Digital-Waters/WaterMonitorDeviceESP32/README.md

# DigitalWaters_WD_prototype
Simplified Schematic for prototype release
