Digital-Waters/WaterMonitorDeviceESP32/(threads)

Thread 2 (2025-07-31):

Mixed 5V, 3.3V rails

atop8918, 2025-07-31:
I mixed the 3.3V and 5V rails with some peripherals -- namely the DH20 internal temp / humidity sensor and the Atlas Scientific isolation board. These are powered by the 5V and switched 5V rails, respectively but both are connected to the 3.3V I2C bus.
Solution:
- Add a 3.3V switched rail and connect both DH20 and Electrial Isolation peripherals to this rail rather than their current 5V rails.

Thread 5 (2025-08-09):

Identify and implement a more reliable sensor connection scheme

atop8918, 2025-08-09:
We are dealing with a number of different probe types. Some come with BNC connectors, some with mini BNC (SMA?) and still others are bare wire or other types.
For our potentially highly-humid environment, standard tin/nickel plated connectors will quickly corrode resulting in unreliable data. A step up would have us using gold-plated connectors but that is both more expensive and has some other corrosion pathways (mixed metal connections, e.g. nickel plating on sensor pins and gold plating on socket may result in galvanic corrosion.

Ideally sensors would be soldered directly to the PCB and then potted or use waterproof IP68+ connections. This is a big TBD.

Thread 6 (2025-08-09):

Sustainability

atop8918, 2025-08-09:
One core goal of DW is to do water monitoring without introducing a lot of additional waste. Instead of using traditional PCBs it would be nice if we could instead use some kind of compostable substrate such as paper or PLA. This may require the use of additive circuit manufacturing rather than traditional chemical etching but it will provide a very big step in sustainability. It will also require some field testing to ensure that some decent minimum device lifetime is achieved.

Thread 7 (2025-08-10):

As a device I need a more quantitative water colour sensor.

atop8918, 2025-08-10:
Using a camera coupled with "white" LEDs as a colour detector has some drawbacks:
Camera CCDs are usually tuned to RGB pixels -- likewise "white" LEDs are typically composed of RGB elements. While to our eyes this looks fine, in the real world there are distinct wavelengths that can get lost when either illuminated or detected with a 3-base colour scheme. Sodium, for example, has a very distinct 'D' spectral line at ~588nm. This corresponds to a gap in between many CCD detectors between the peak red and green pixels at ~600nm and ~520nm, respectively. Those wavelengths also correspond to LED illumination of the same colours.
To this end, using a multi-spectral colour detector such as the AS73343 with 14 colour channels, including 11 visible-light detectors, IR, and clear detectors. Using multi-spectral LEDs or additional coloured / phospohered LEDs in order to "fill in tht gaps" that many ordinary white LEDs leave would also provide better colour data overall.

Why is this important? Spectral information  provides a lot of quantitative data about the content of the water, and can be coupled with other sensoor data to help design a data model. Illumination and spectral sensors are very cheap compared with other water quality sensors, and can potentially provide more data on biological and turbidity conditions.

Thread 10 (2025-08-11):

Swap TLV4387 with 2387 for cost savings

atop8918, 2025-08-11:
The TLV4387 buffered reference outputs seem like they are stiff enough to be shared rather than have separate buffers for different circuits. This would save some money as the TLV is a relatively expensive part.

Thread 11 (2025-08-11):

Audit powerup requirements for switched power components

atop8918, 2025-08-11:
Some of the switched components on the board do not seem to like the power going out on them. Namely the DHT20 doesn't reliably recover after a switch-on event.
This is with rellatively fast on-off switching ( 5-10 seconds off ) so it is possible that with a more reasonably on-off schedule the unit will be more coperative. It is also reasonable to assume that the unit needs more stringent power up rail requirements and so we may need to provide a more consistent power on sequence.

Thread 8 (2025-08-11):

Silkscreen additions

atop8918, 2025-08-11:
Some of the connectors are pretty ambiguous -- especially considering that they are non-polarized 2 or 3-pin headers. For the next rev, if headers are still used, we'll need some more info like pin 1, or Vcc/GND, etc. indicators to avoid plugging some of the polarized sensors in backwards (e.g. the turbidity sensor)

Thread 9 (2025-08-11):

Vref to ADC is not stiff enough

atop8918, 2025-08-11:
The 4.096 reference voltage to the ADC is not stiff enough to handle the power peaks when sampling. This pin is supplied directly from the 4.096 voltage regulator (REF3040) but jumps quite a bit when the ADC is sampling. The ripple is coupling to the buffered 4096V reference lines which effects those circuits as well.
I think a better approach might be to supply the ADC with either one of the existing buffered 4.096 lines or to add another op amp buffer.
Note: This is confirmed: removed ADC Vref from the 3040 and attached to pin 1 of the TLV4387 and no ripple is evident when sampling.

Additional: I will add this as a feature request, but we may be able to use a smaller buffer op amp (TLV2387) to save some money and board space as the buffers seem stiff enough to be shared.

Thread 13 (2025-08-19):

As a system I would like a "dirty" flag to mark uncorrected data records

atop8918, 2025-08-19:
Calibration corrections will be supplied with each device for each sensor via the external EEPROM. There is the possibility that this record will become corrupt or deleted or have failed to have been written in the first place. Data coming from these devices should be marked "dirty" so they can be corrected later.
We should have a copy of each device's calibration table in the database associated with the device entry. The cal values can be used to correct the data in the cloud when being used or by some periodically running batch script.

Thread 14 (2025-08-19):

As a device I need to expose the ADC reference voltage for calibration

atop8918, 2025-08-19:
We need at a test point near the ADC VREF pin (MC3208 pin 15) and the analog ground pin (pin 14). For production these should be routed from each board through the platter/carrier to a debug header for bulk calibration.
