Digital-Waters/WaterMonitorDeviceESP32/board.pdf

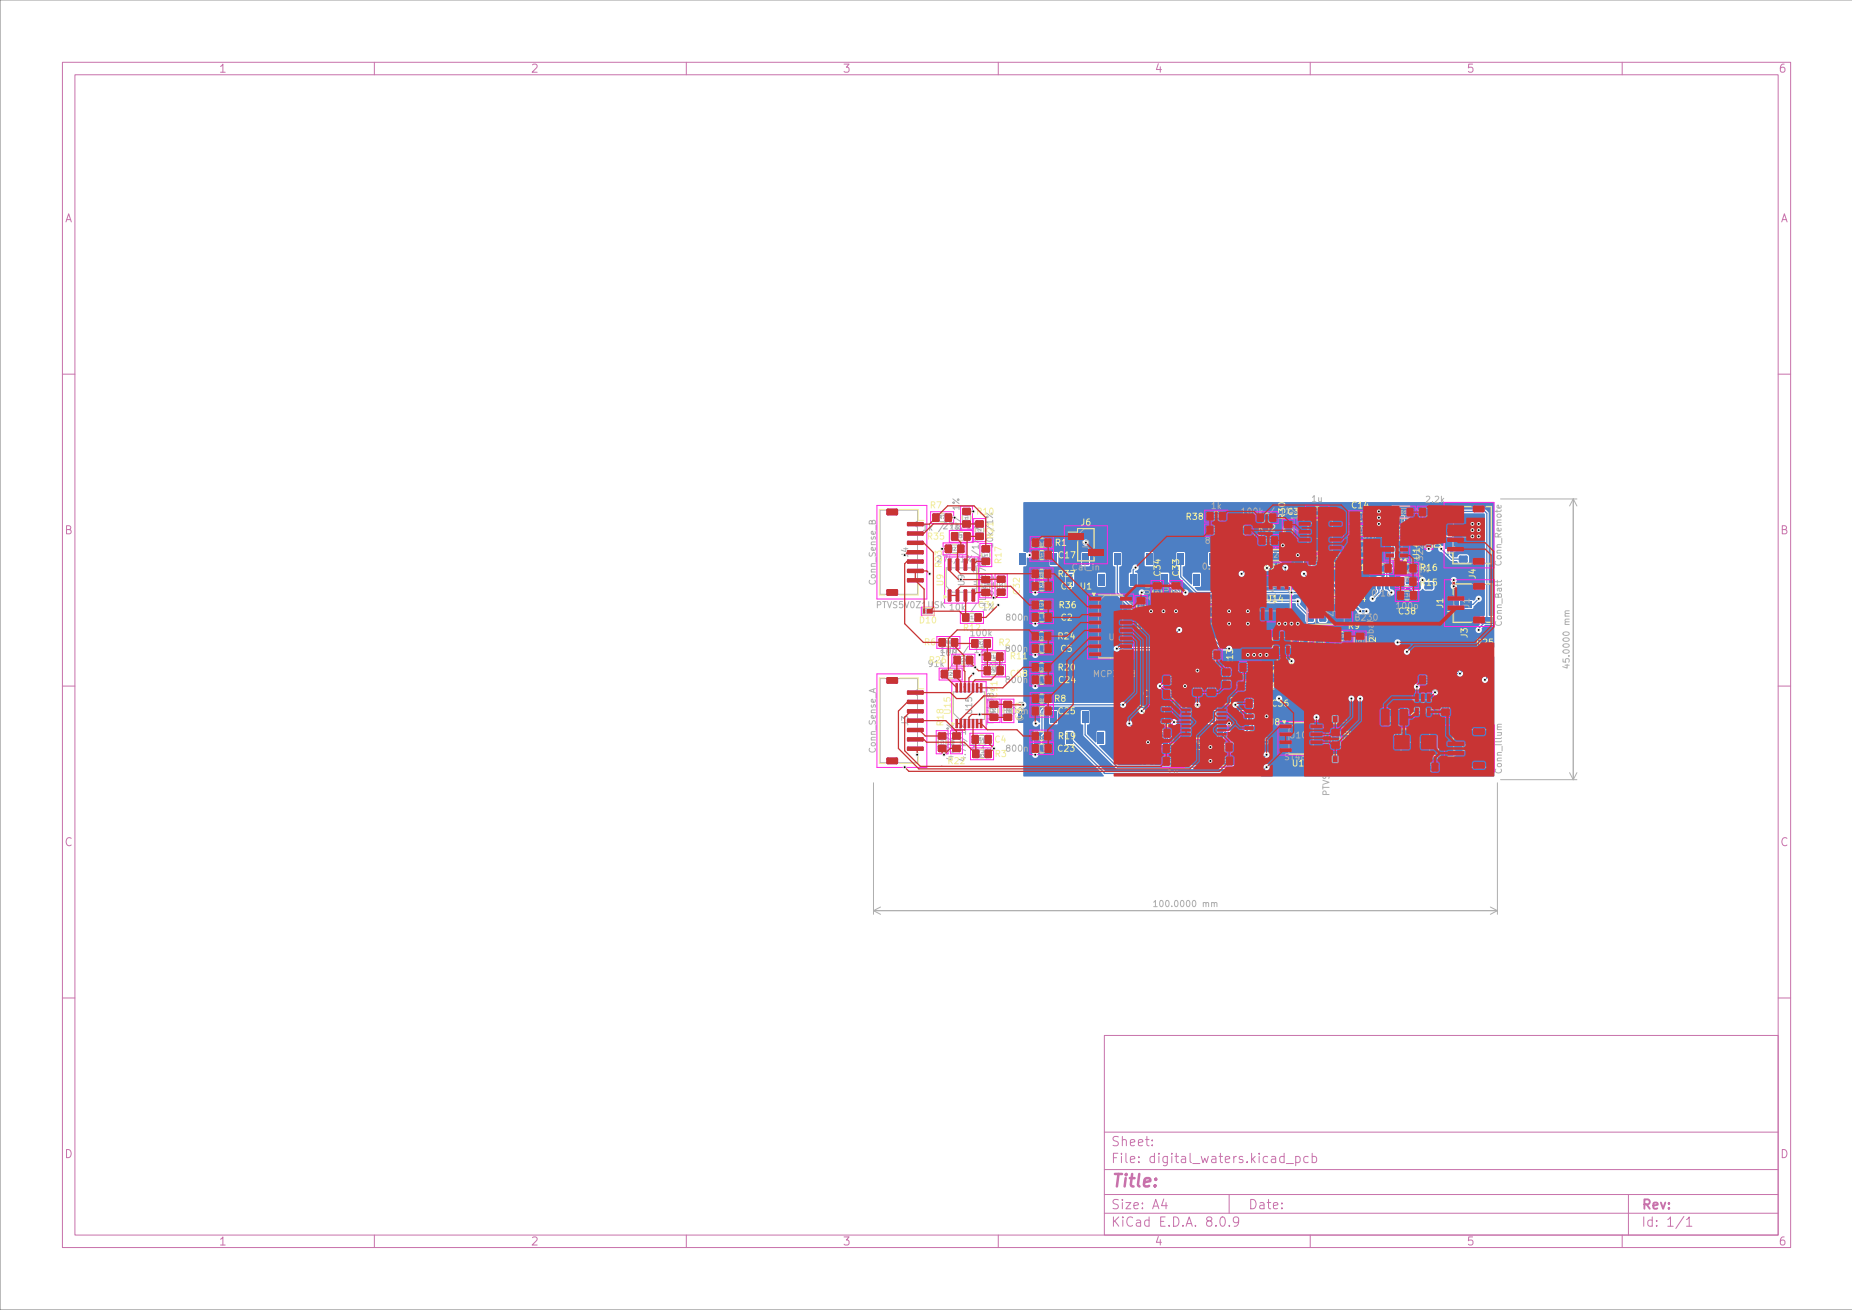
[picture p1: page 1]
