Digital-Waters/WaterMonitorDeviceESP32/digital_waters.kicad_pcb

## KiCad design digital_waters.kicad_pcb (2025-11-18)

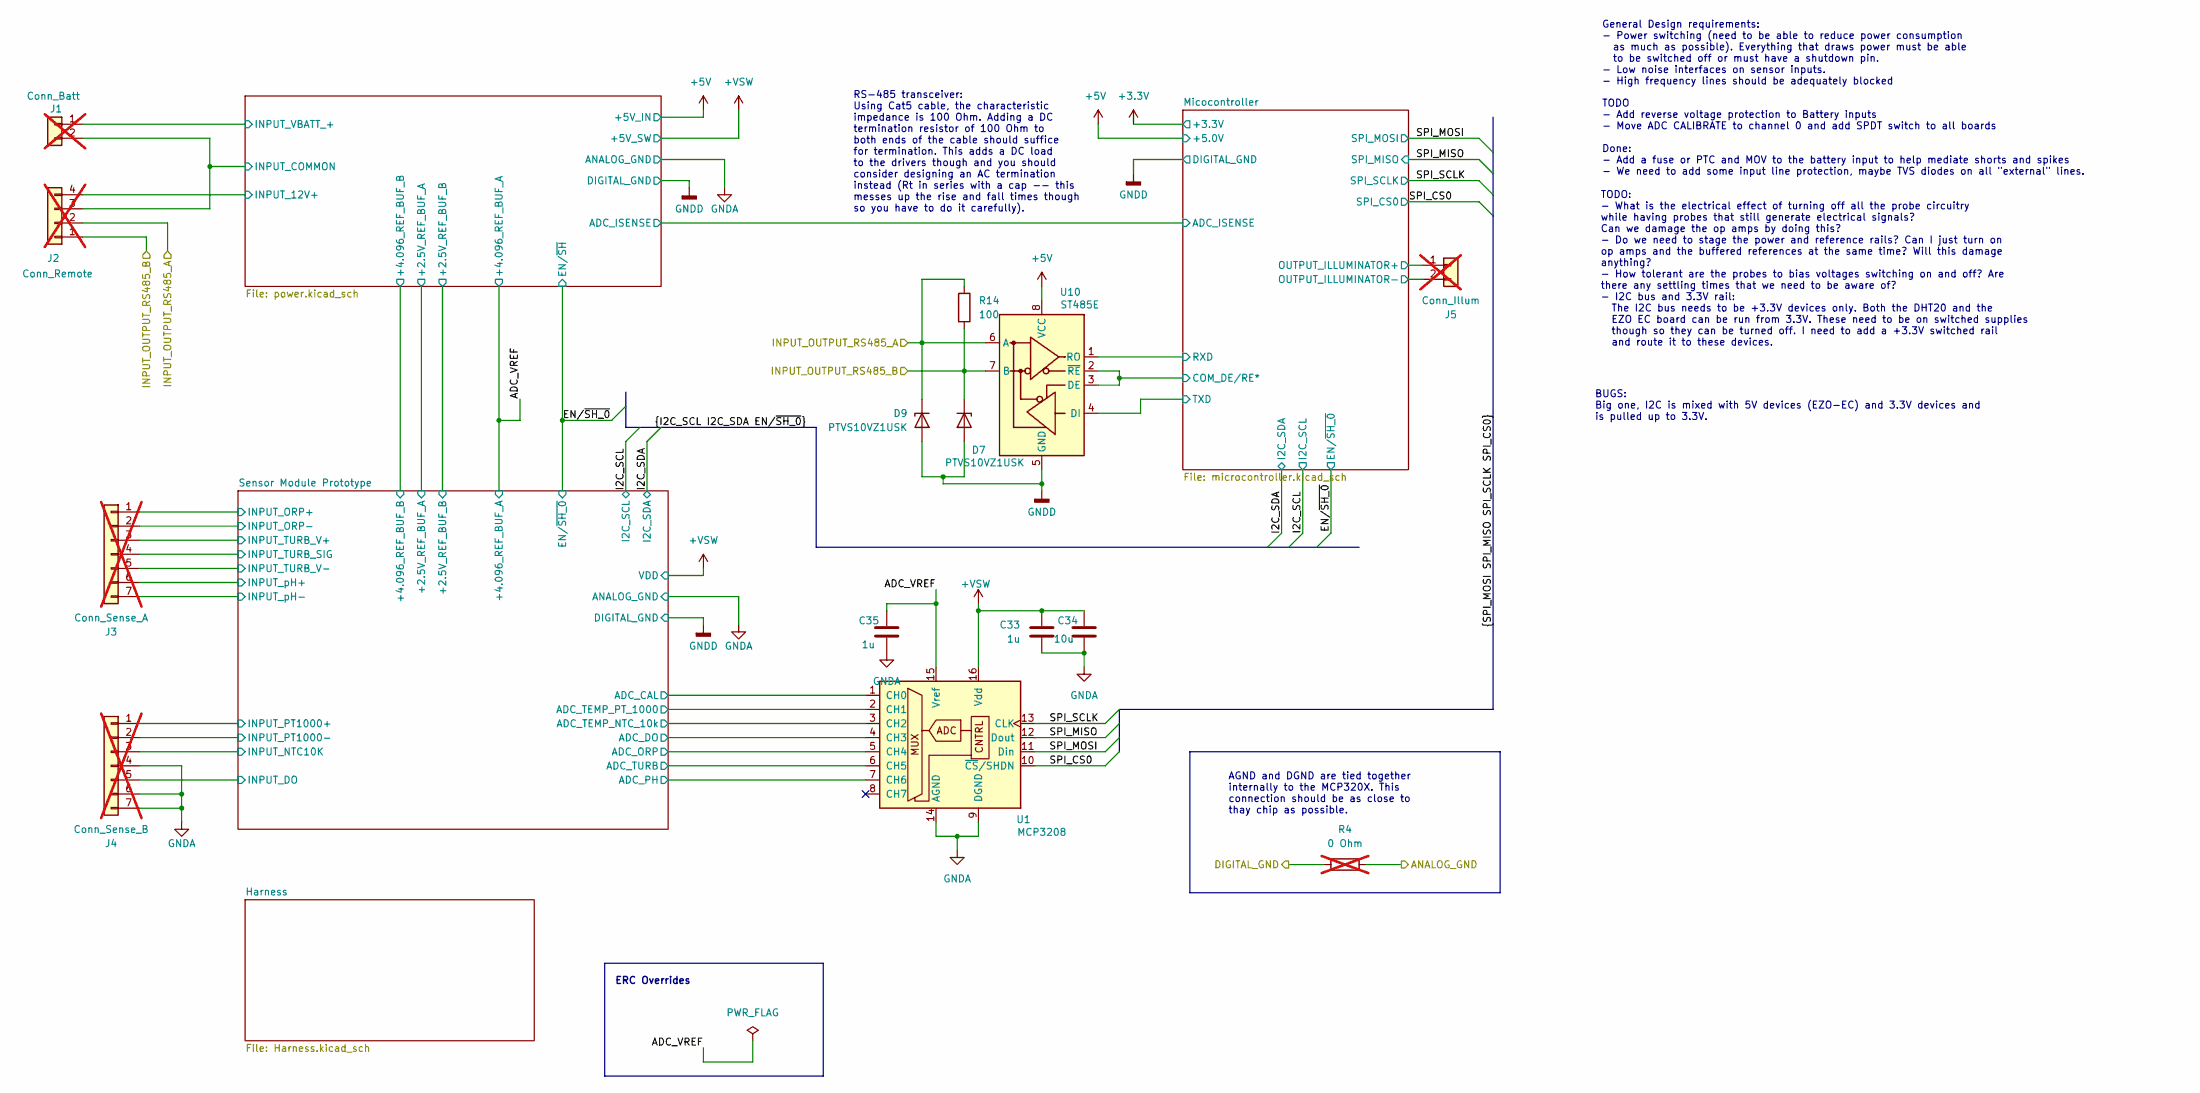
[picture p6: schematic digital_waters.kicad_sch]

Parts:
C33, C35: 1u; C_0805_2012Metric_Pad1.18x1.45mm_HandSolder; MPN CL21B105KOFNNNG
C34: 10u; C_0805_2012Metric_Pad1.18x1.45mm_HandSolder; MPN CL21B106KPQNNNE
D7, D9: PTVS10VZ1USK; Nexperia_DSN1608-2_1.6x0.8mm; MPN PTVS10VZ1USK
J1: Conn_Batt; JST_ZH_S2B-ZR-SM4A-TF_1x02-1MP_P1.50mm_Horizontal; not fitted
J2: Conn_Remote; JST_ZH_S4B-ZR-SM4A-TF_1x04-1MP_P1.50mm_Horizontal; not fitted
J3: Conn_Sense_A; JST_ZH_S7B-ZR-SM4A-TF_1x07-1MP_P1.50mm_Horizontal; not fitted
J4: Conn_Sense_B; JST_ZH_S7B-ZR-SM4A-TF_1x07-1MP_P1.50mm_Horizontal; not fitted
J5: Conn_Illum; JST_ZH_S2B-ZR-SM4A-TF_1x02-1MP_P1.50mm_Horizontal; not fitted
R4: 0 Ohm; R_1206_3216Metric_Pad1.30x1.75mm_HandSolder; not fitted
R14: 100; R_0805_2012Metric_Pad1.20x1.40mm_HandSolder; MPN AC0805FR-7W100RL
U1: MCP3208; SOIC-16_3.9x9.9mm_P1.27mm; MPN MCP3208-CI/SL
U10: ST485E; SOIC-8_3.9x4.9mm_P1.27mm; MPN ST485EBDR

Connections:
+5V: U10.8 (VCC); also elsewhere on the board
+VSW: C33.1, C34.1, U1.16 (Vdd); also elsewhere on the board
/ADC_VREF: C35.1, U1.15 (Vref); also elsewhere on the board
/INPUT_OUTPUT_RS485_A: D9.1 (K), J2.2, R14.1, U10.6 (A)
/INPUT_OUTPUT_RS485_B: D7.1 (K), J2.1, R14.2, U10.7 (B)
/Micocontroller/COM_DE/RE*: U10.2 (~RE), U10.3 (DE); also elsewhere on the board
/Micocontroller/OUTPUT_ILLUMINATOR+: J5.1; also elsewhere on the board
/Micocontroller/OUTPUT_ILLUMINATOR-: J5.2; also elsewhere on the board
/Micocontroller/RXD: U10.1 (RO); also elsewhere on the board
/Micocontroller/TXD: U10.4 (DI); also elsewhere on the board
/Power/+2.5V_REF_BUF_A: J3.7; also elsewhere on the board
/Power/+2.5V_REF_BUF_B: J3.2; also elsewhere on the board
/Power/+4.096_REF_BUF_B: J3.3; also elsewhere on the board
/Power/INPUT_12V+: J2.4; also elsewhere on the board
/Power/INPUT_COMMON: J1.2, J2.3; also elsewhere on the board
/Power/INPUT_VBATT_+: J1.1; also elsewhere on the board
/SPI_CS0: U1.10 (~CS/SHDN); also elsewhere on the board
/SPI_MISO: U1.12 (Dout); also elsewhere on the board
/SPI_MOSI: U1.11 (Din); also elsewhere on the board
/SPI_SCLK: U1.13 (CLK); also elsewhere on the board
/Sensor Module Prototype/ADC_CAL: U1.1 (CH0); also elsewhere on the board
/Sensor Module Prototype/ADC_DO: U1.4 (CH3); also elsewhere on the board
/Sensor Module Prototype/ADC_ORP: U1.5 (CH4); also elsewhere on the board
/Sensor Module Prototype/ADC_PH: U1.7 (CH6); also elsewhere on the board
/Sensor Module Prototype/ADC_TEMP_NTC_10k: U1.3 (CH2); also elsewhere on the board
/Sensor Module Prototype/ADC_TEMP_PT_1000: U1.2 (CH1); also elsewhere on the board
/Sensor Module Prototype/ADC_TURB: U1.6 (CH5); also elsewhere on the board
/Sensor Module Prototype/INPUT_DO: J4.5; also elsewhere on the board
/Sensor Module Prototype/INPUT_NTC10K: J4.3; also elsewhere on the board
/Sensor Module Prototype/INPUT_ORP+: J3.1; also elsewhere on the board
/Sensor Module Prototype/INPUT_PT1000+: J4.1; also elsewhere on the board
/Sensor Module Prototype/INPUT_PT1000-: J4.2; also elsewhere on the board
/Sensor Module Prototype/INPUT_TURB_SIG: J3.4; also elsewhere on the board
/Sensor Module Prototype/INPUT_TURB_V-: J3.5; also elsewhere on the board
/Sensor Module Prototype/INPUT_pH+: J3.6; also elsewhere on the board
GNDA: C33.2, C34.2, C35.2, J4.4, J4.6, J4.7, R4.2, U1.9 (DGND), U1.14 (AGND); also elsewhere on the board
GNDD: D7.2 (A), D9.2 (A), R4.1, U10.5 (GND); also elsewhere on the board

Notes on the sheet:
BUGS: Big one, I2C is mixed with 5V devices (EZO-EC) and 3.3V devices and is pulled up to 3.3V.
TODO: - What is the electrical effect of turning off all the probe circuitry while having probes that still generate electrical signals? Can we damage the op amps by doing this? - Do we need to stage the power and reference rails? Can I just turn on op amps and the buffered references at the same t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
RS-485 transceiver: Using Cat5 cable, the characteristic impedance is 100 Ohm. Adding a DC termination resistor of 100 Ohm to both ends of the cable should suffice for termination. This adds a DC load to the drivers though and you should consider designing an AC termination instead (Rt in series wi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
ERC Overrides
AGND and DGND are tied together internally to the MCP320X. This connection should be as close to thay chip as possible.
TODO - Add reverse voltage protection to Battery inputs - Move ADC CALIBRATE to channel 0 and add SPDT switch to all boards Done: - Add a fuse or PTC and MOV to the battery input to help mediate shorts and spikes - We need to add some input line protection, maybe TVS diodes on all "external" lines.
General Design requirements: - Power switching (need to be able to reduce power consumption as much as possible). Everything that draws power must be able to be switched off or must have a shutdown pin. - Low noise interfaces on sensor inputs. - High frequency lines should be adequately blocked

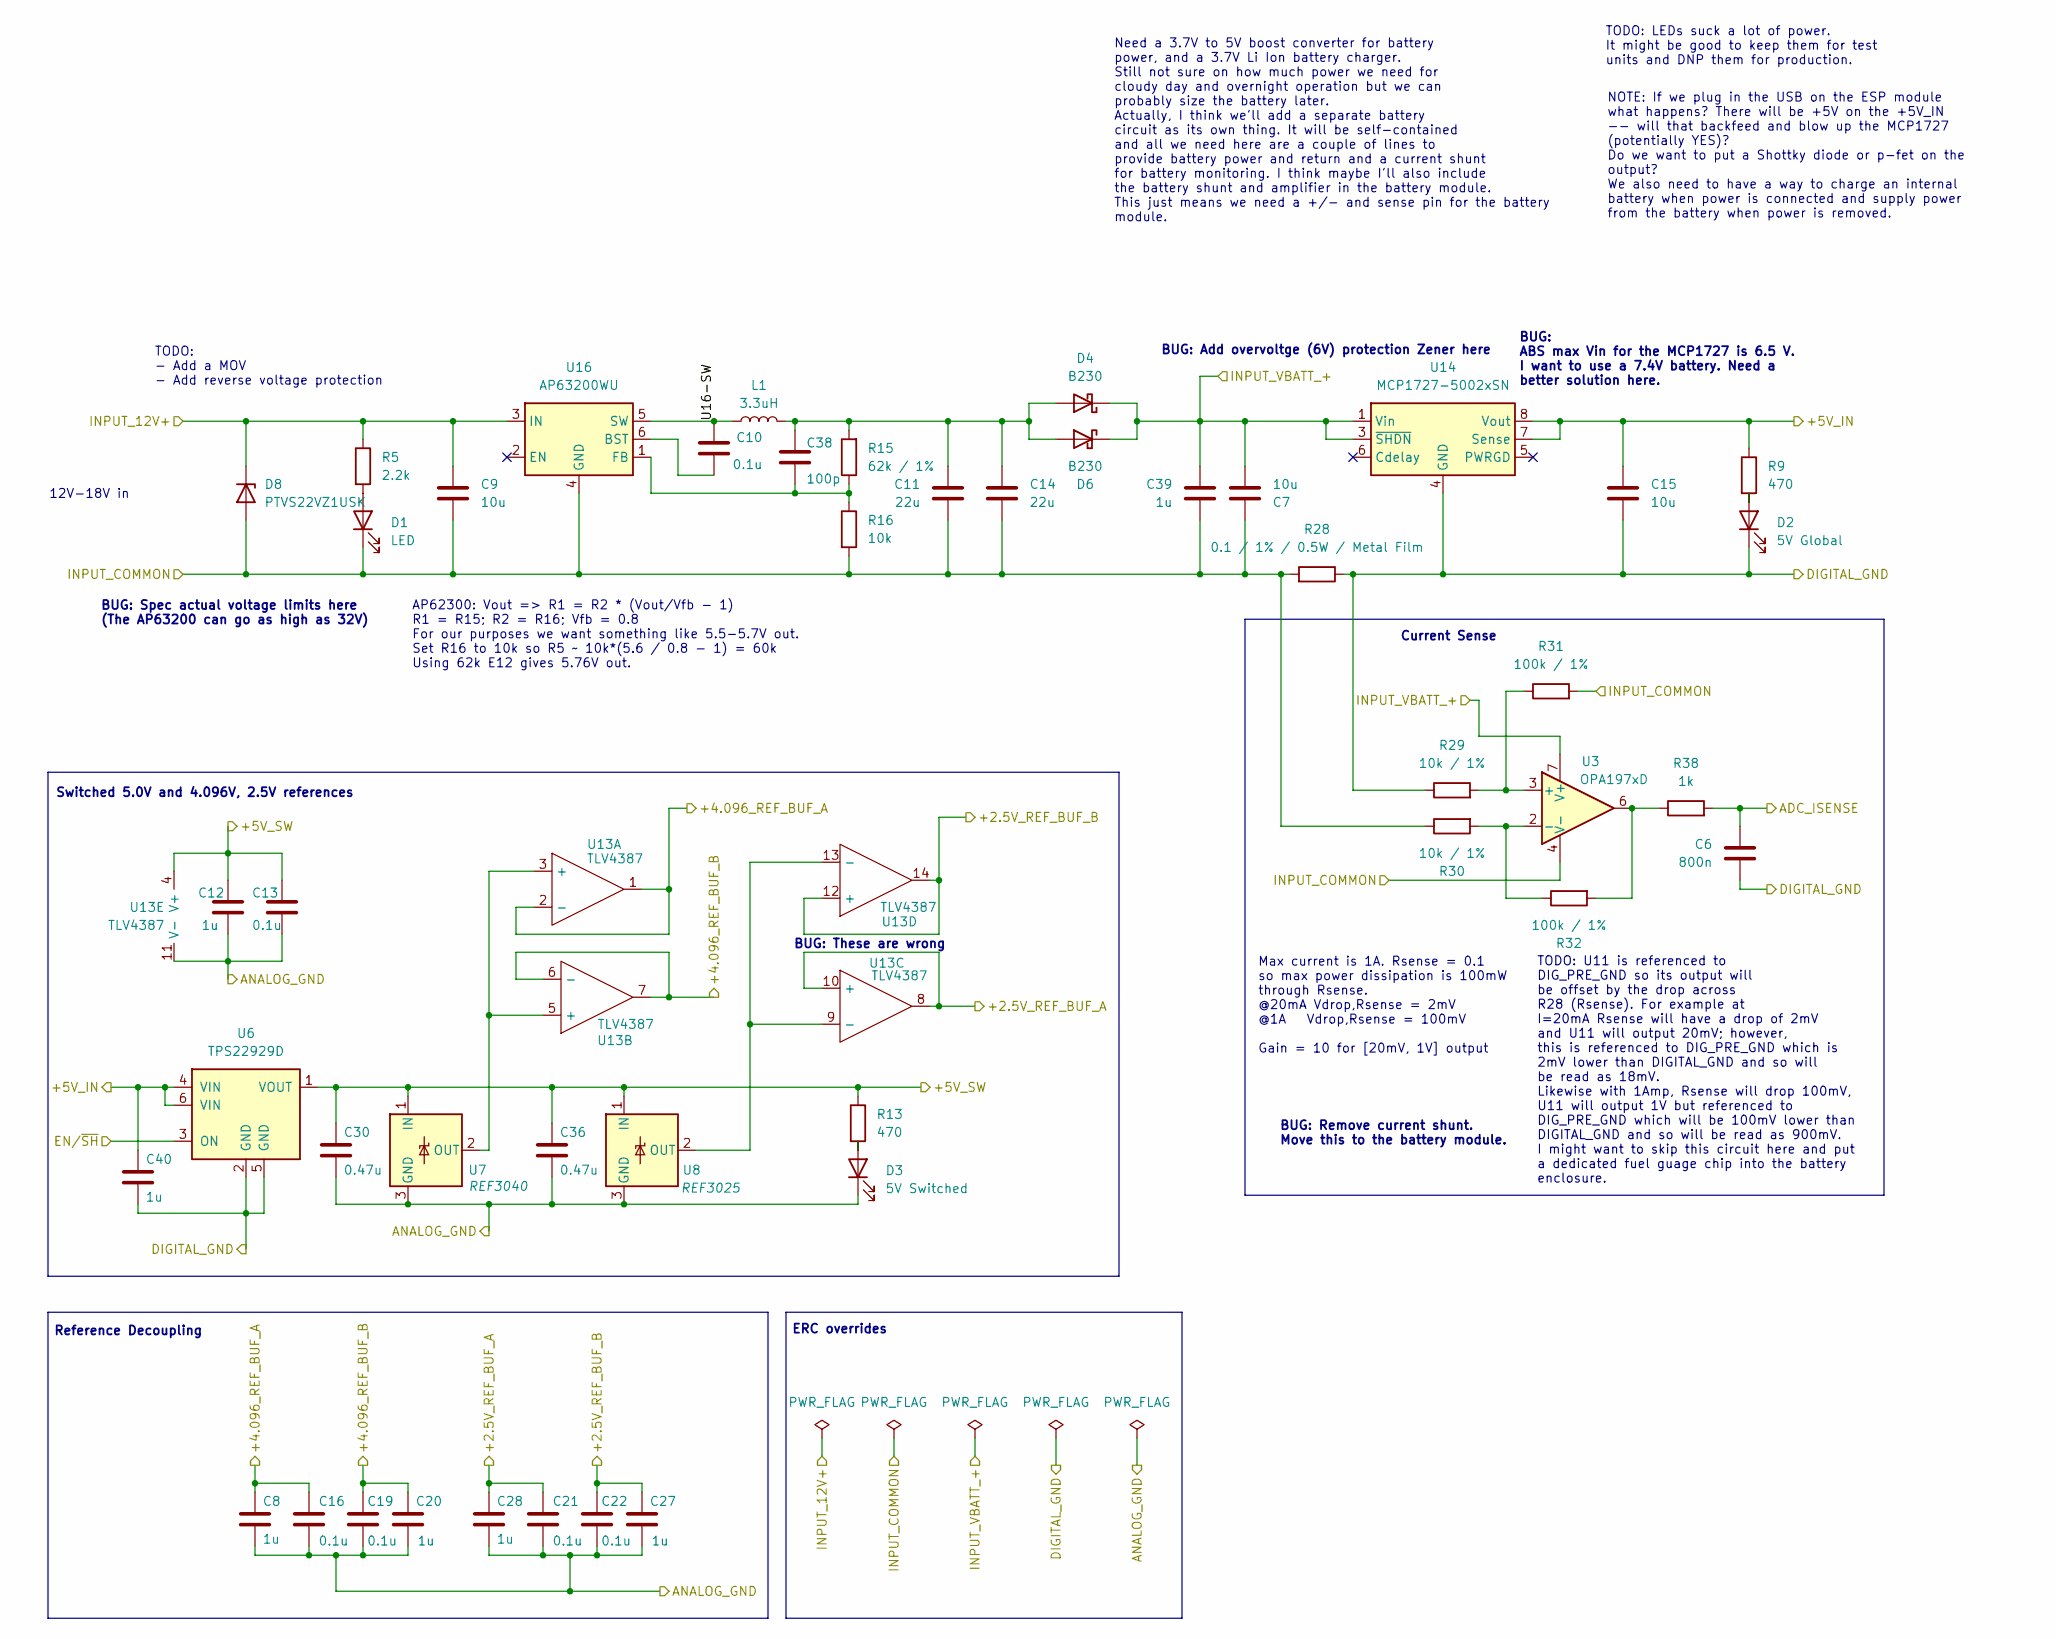
[picture p7: schematic power.kicad_sch]

Parts:
C6: 800n; C_0805_2012Metric_Pad1.18x1.45mm_HandSolder; MPN CC0805KKX7R7BB824
C7, C9, C15: 10u; C_0805_2012Metric_Pad1.18x1.45mm_HandSolder; MPN CL21B106KPQNNNE
C8, C12, C20, C27, C28, C39, C40: 1u; C_0805_2012Metric_Pad1.18x1.45mm_HandSolder; MPN CL21B105KOFNNNG
C10, C13, C16, C19, C21, C22: 0.1u; C_0805_2012Metric_Pad1.18x1.45mm_HandSolder; MPN CC0805KRX7R7BB104
C11, C14: 22u; C_0805_2012Metric_Pad1.18x1.45mm_HandSolder; MPN GRM21BZ71A226ME15L
C30, C36: 0.47u; C_0805_2012Metric_Pad1.18x1.45mm_HandSolder; MPN CL21B474KOFNNNE
C38: 100p; C_0805_2012Metric_Pad1.18x1.45mm_HandSolder; MPN C0805C101M4RACTU
D1: LED; LED_0805_2012Metric_Pad1.15x1.40mm_HandSolder; MPN LTST-C170GKT
D2: 5V Global; LED_0805_2012Metric_Pad1.15x1.40mm_HandSolder; MPN LTST-C170GKT
D3: 5V Switched; LED_0805_2012Metric_Pad1.15x1.40mm_HandSolder; MPN LTST-C170GKT
D4, D6: B230; D_SMB; MPN B230-13-F
D8: PTVS22VZ1USK; Nexperia_DSN1608-2_1.6x0.8mm; MPN PTVS22VZ1USK
L1: 3.3uH; L_1210_3225Metric_Pad1.42x2.65mm_HandSolder; MPN DFE322512F-3R3M=P2
R5: 2.2k; R_0805_2012Metric_Pad1.20x1.40mm_HandSolder; MPN AC0805FR-7W2K2L
R9, R13: 470; R_0805_2012Metric_Pad1.20x1.40mm_HandSolder; MPN RCC0805470RFKEA
R15: 62k / 1%; R_0805_2012Metric_Pad1.20x1.40mm_HandSolder; MPN RK73H2ATTD6202F
R16: 10k; R_0805_2012Metric_Pad1.20x1.40mm_HandSolder; MPN AC0805FR-7W10KL
R28: 0.1 / 1% / 0.5W / Metal Film; R_1206_3216Metric_Pad1.30x1.75mm_HandSolder; MPN PE1206FRF7W0R1L
R29, R30: 10k / 1%; R_0805_2012Metric_Pad1.20x1.40mm_HandSolder; MPN AC0805FR-7W10KL
R31, R32: 100k / 1%; R_0805_2012Metric_Pad1.20x1.40mm_HandSolder; MPN AC0805FR-7W100KL
R38: 1k; R_0805_2012Metric_Pad1.20x1.40mm_HandSolder; MPN AC0805FR-7W1KL
U3: OPA197xD; SOIC-8_3.9x4.9mm_P1.27mm; MPN OPA197ID
U6: TPS22929D; SOT-23-6; MPN TPS22929DDBVR
U7: REF3040; SOT-23; MPN REF3040AIDBZR
U8: REF3025; SOT-23; MPN REF3025AIDBZR
U13: TLV4387; TSSOP-14_4.4x5mm_P0.65mm; MPN TLV4387PWR
U14: MCP1727-5002xSN; SOIC-8_3.9x4.9mm_P1.27mm; MPN MCP1727-5002E/SN
U16: AP63200WU; TSOT-23-6; MPN AP63200WU-7

Connections:
+5V: C15.1, C40.1, R9.1, U6.4 (VIN), U6.6 (VIN), U14.7 (Sense), U14.8 (Vout); also elsewhere on the board
+VSW: C12.1, C13.1, C30.1, C36.1, R13.1, U6.1 (VOUT), U7.1 (IN), U8.1 (IN), U13.4 (V+); also elsewhere on the board
/ADC_VREF: C8.1, C16.1, U13.1, U13.2 (-); also elsewhere on the board
/EN/~SH_0: U6.3 (ON); also elsewhere on the board
/Micocontroller/ADC_ISENSE: C6.1, R38.2; also elsewhere on the board
/Power/+2.5V_REF_BUF_A: C21.1, C28.1, U13.8, U13.10 (+); also elsewhere on the board
/Power/+2.5V_REF_BUF_B: C22.1, C27.1, U13.12 (+), U13.14; also elsewhere on the board
/Power/+4.096_REF_BUF_B: C19.1, C20.1, U13.6 (-), U13.7; also elsewhere on the board
/Power/INPUT_12V+: C9.1, D8.1 (K), R5.1, U16.3 (IN); also elsewhere on the board
/Power/INPUT_COMMON: C7.1, C9.2, C11.2, C14.2, C39.2, D1.1 (K), D8.2 (A), R16.2, R28.2, R30.1, R31.2, U3.4 (V-), U16.4 (GND); also elsewhere on the board
/Power/INPUT_VBATT_+: C7.2, C39.1, D4.1 (K), D6.1 (K), U3.7 (V+), U14.1 (Vin), U14.2 (Vin), U14.3 (~SHDN); also elsewhere on the board
/Power/U16-SW: C10.2, L1.1, U16.5 (SW)
GNDA: C8.2, C12.2, C13.2, C16.2, C19.2, C20.2, C21.2, C22.2, C27.2, C28.2, C30.2, C36.2, D3.1 (K), U7.3 (GND), U8.3 (GND), U13.11 (V-); also elsewhere on the board
GNDD: C6.2, C15.2, C40.2, D2.1 (K), R28.1, R29.1, U6.2 (GND), U6.5 (GND), U14.4 (GND); also elsewhere on the board
unnamed: D1.2 (A), R5.2
unnamed: D2.2 (A), R9.2
unnamed: D3.2 (A), R13.2
unnamed: C11.1, C14.1, C38.1, D4.2 (A), D6.2 (A), L1.2, R15.2
unnamed: R32.2, R38.1, U3.6
unnamed: R29.2, R31.1, U3.3 (+)
unnamed: R30.2, R32.1, U3.2 (-)
unnamed: U7.2 (OUT), U13.3 (+), U13.5 (+)
unnamed: U8.2 (OUT), U13.9 (-), U13.13 (-)
unnamed: C10.1, U16.6 (BST)
unnamed: C38.2, R15.1, R16.1, U16.1 (FB)

Notes on the sheet:
TODO: LEDs suck a lot of power. It might be good to keep them for test units and DNP them for production.
BUG: ABS max Vin for the MCP1727 is 6.5 V. I want to use a 7.4V battery. Need a better solution here.
AP62300: Vout => R1 = R2 * (Vout/Vfb - 1) R1 = R15; R2 = R16; Vfb = 0.8 For our purposes we want something like 5.5-5.7V out. Set R16 to 10k so R5 ~ 10k*(5.6 / 0.8 - 1) = 60k Using 62k E12 gives 5.76V out.
12V-18V in
BUG: These are wrong
Max current is 1A. Rsense = 0.1 so max power dissipation is 100mW through Rsense. @20mA Vdrop,Rsense = 2mV @1A Vdrop,Rsense = 100mV Gain = 10 for [20mV, 1V] output
BUG: Add overvoltge (6V) protection Zener here
BUG: Spec actual voltage limits here (The AP63200 can go as high as 32V)
Current Sense
Reference Decoupling
BUG: Remove current shunt. Move this to the battery module.
TODO: U11 is referenced to DIG_PRE_GND so its output will be offset by the drop across R28 (Rsense). For example at I=20mA Rsense will have a drop of 2mV and U11 will output 20mV; however, this is referenced to DIG_PRE_GND which is 2mV lower than DIGITAL_GND and so will be read as 18mV. Likewise wi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
ERC overrides
Need a 3.7V to 5V boost converter for battery power, and a 3.7V Li Ion battery charger. Still not sure on how much power we need for cloudy day and overnight operation but we can probably size the battery later. Actually, I think we'll add a separate battery circuit as its own thing. It will be sel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
Switched 5.0V and 4.096V, 2.5V references
TODO: - Add a MOV - Add reverse voltage protection
NOTE: If we plug in the USB on the ESP module what happens? There will be +5V on the +5V_IN -- will that backfeed and blow up the MCP1727 (potentially YES)? Do we want to put a Shottky diode or p-fet on the output? We also need to have a way to charge an internal battery when power is connected and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

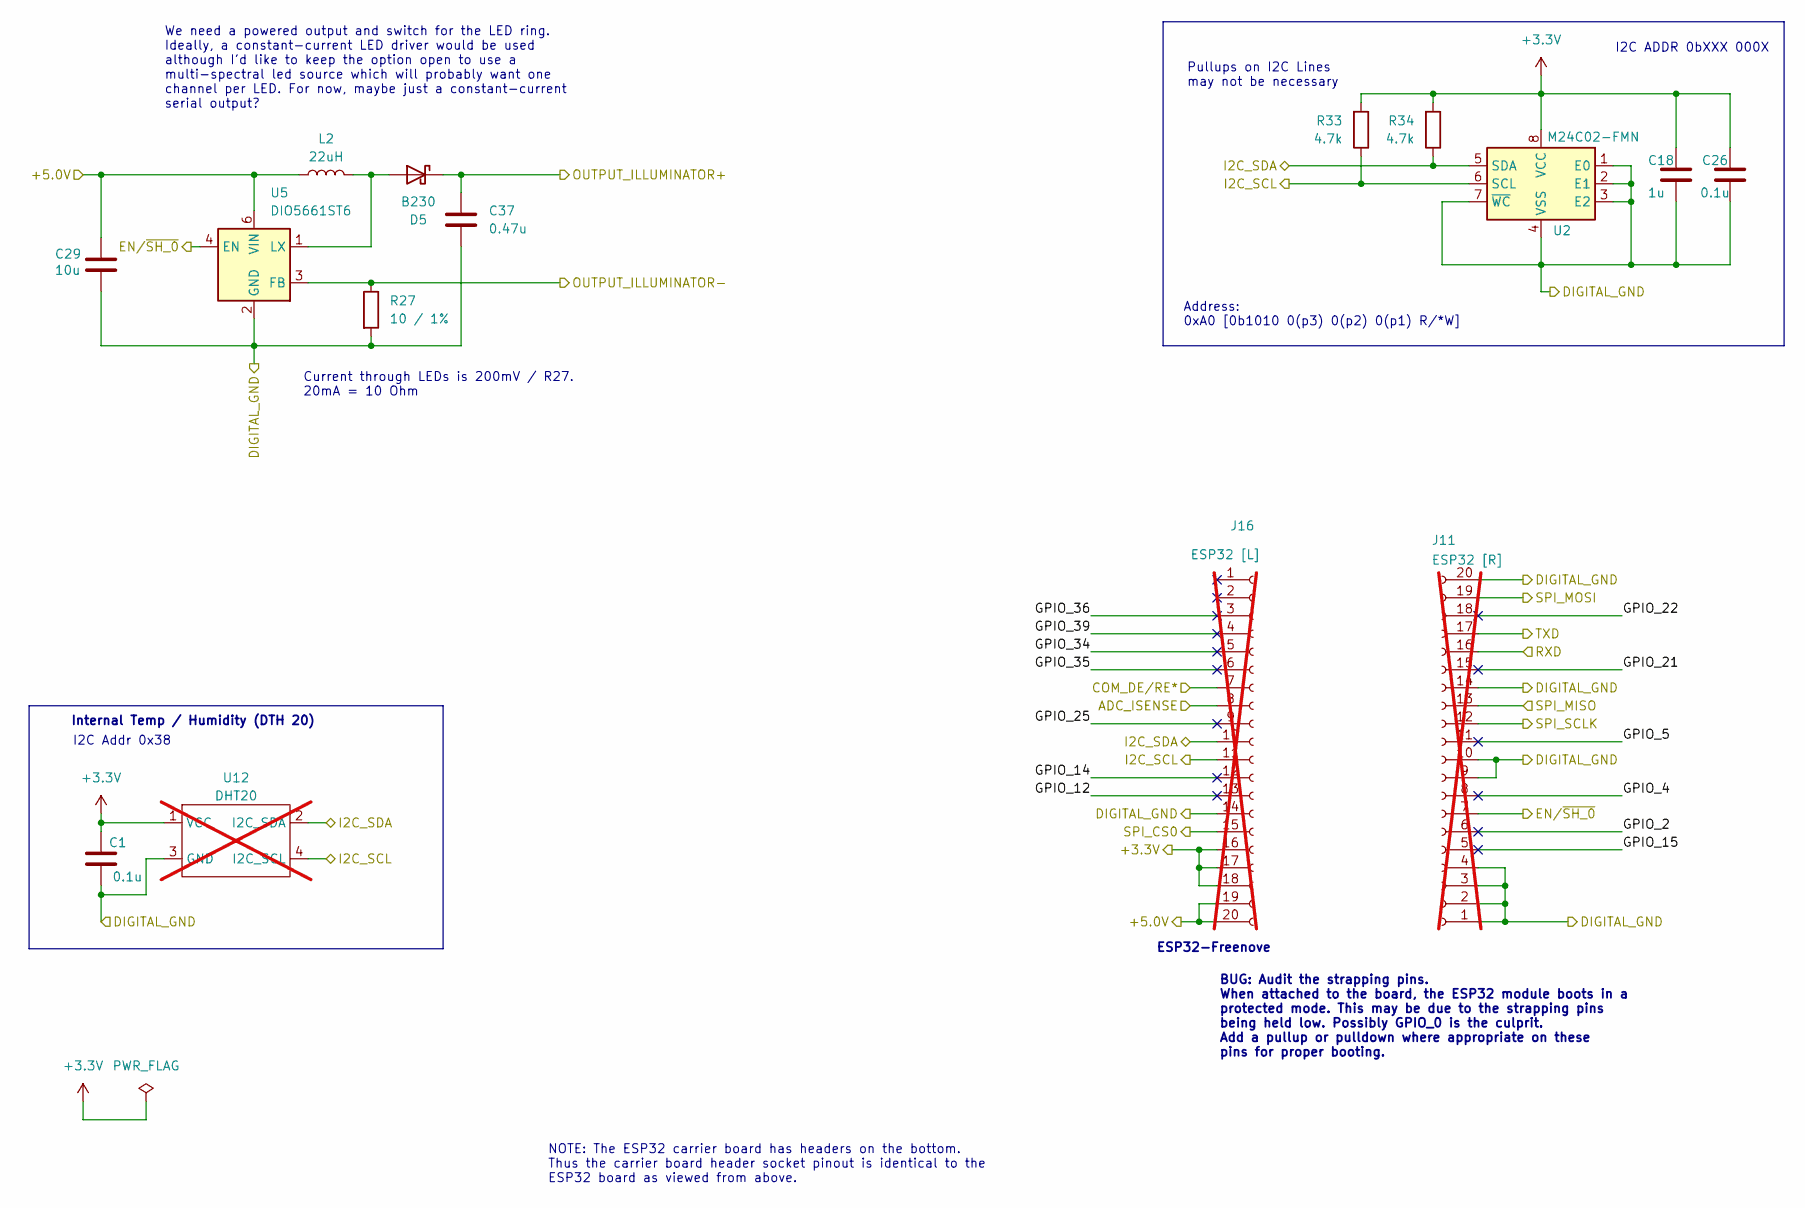
[picture p8: schematic microcontroller.kicad_sch]

Parts:
C1, C26: 0.1u; C_0805_2012Metric_Pad1.18x1.45mm_HandSolder; MPN CC0805KRX7R7BB104
C18: 1u; C_0805_2012Metric_Pad1.18x1.45mm_HandSolder; MPN CL21B105KOFNNNG
C29: 10u; C_0805_2012Metric_Pad1.18x1.45mm_HandSolder; MPN CL21B106KPQNNNE
C37: 0.47u; C_0805_2012Metric_Pad1.18x1.45mm_HandSolder; MPN CL21B474KOFNNNE
D5: B230; D_SMB; MPN B230-13-F
J11: ESP32 [R]; PinSocket_1x20_P2.54mm_Vertical_SMD_Pin1Left; not fitted
J16: ESP32 [L]; PinSocket_1x20_P2.54mm_Vertical_SMD_Pin1Left; not fitted
L2: 22uH; L_1210_3225Metric_Pad1.42x2.65mm_HandSolder; MPN CBC3225T220KR
R27: 10 / 1%; R_0805_2012Metric_Pad1.20x1.40mm_HandSolder; MPN AC0805FR-7W10RL
R33, R34: 4.7k; R_0805_2012Metric_Pad1.20x1.40mm_HandSolder; MPN AC0805FR-7W4K7L
U2: M24C02-FMN; SOIC-8_3.9x4.9mm_P1.27mm; MPN M24C02-FMN
U5: DIO5661ST6; SOT-23-6; MPN DIO5661ST6
U12: DHT20; PinSocket_1x04_P2.54mm_Vertical_SMD_Pin1Left; not fitted

Connections:
+3.3V: C1.1, C18.1, C26.1, J16.16, J16.17, J16.18, R33.2, R34.2, U2.8 (VCC), U12.1 (VCC); also elsewhere on the board
+5V: C29.1, J16.19, J16.20, L2.1, U5.6 (VIN); also elsewhere on the board
/EN/~SH_0: J11.7, U5.4 (EN); also elsewhere on the board
/I2C_SCL: J16.11, R33.1, U2.6 (SCL), U12.4 (I2C_SCL); also elsewhere on the board
/I2C_SDA: J16.10, R34.1, U2.5 (SDA), U12.2 (I2C_SDA); also elsewhere on the board
/Micocontroller/ADC_ISENSE: J16.8; also elsewhere on the board
/Micocontroller/COM_DE/RE*: J16.7; also elsewhere on the board
/Micocontroller/GPIO_2: J11.6
/Micocontroller/GPIO_4: J11.8
/Micocontroller/GPIO_5: J11.11
/Micocontroller/GPIO_12: J16.13
/Micocontroller/GPIO_14: J16.12
/Micocontroller/GPIO_15: J11.5
/Micocontroller/GPIO_21: J11.15
/Micocontroller/GPIO_22: J11.18
/Micocontroller/GPIO_25: J16.9
/Micocontroller/GPIO_34: J16.5
/Micocontroller/GPIO_35: J16.6
/Micocontroller/GPIO_36: J16.3
/Micocontroller/GPIO_39: J16.4
/Micocontroller/OUTPUT_ILLUMINATOR+: C37.1, D5.1 (K); also elsewhere on the board
/Micocontroller/OUTPUT_ILLUMINATOR-: R27.1, U5.3 (FB); also elsewhere on the board
/Micocontroller/RXD: J11.16; also elsewhere on the board
/Micocontroller/TXD: J11.17; also elsewhere on the board
/SPI_CS0: J16.15; also elsewhere on the board
/SPI_MISO: J11.13; also elsewhere on the board
/SPI_MOSI: J11.19; also elsewhere on the board
/SPI_SCLK: J11.12; also elsewhere on the board
GNDD: C1.2, C18.2, C26.2, C29.2, C37.2, J11.1, J11.2, J11.3, J11.4, J11.9, J11.10, J11.14, J11.20, J16.14, R27.2, U2.1 (E0), U2.2 (E1), U2.3 (E2), U2.4 (VSS), U2.7 (~WC), U5.2 (GND), U12.3 (GND); also elsewhere on the board
unnamed: D5.2 (A), L2.2, U5.1 (LX)

Notes on the sheet:
Internal Temp / Humidity (DTH 20)
ESP32-Freenove
BUG: Audit the strapping pins. When attached to the board, the ESP32 module boots in a protected mode. This may be due to the strapping pins being held low. Possibly GPIO_0 is the culprit. Add a pullup or pulldown where appropriate on these pins for proper booting.
We need a powered output and switch for the LED ring. Ideally, a constant-current LED driver would be used although I'd like to keep the option open to use a multi-spectral led source which will probably want one channel per LED. For now, maybe just a constant-current serial output?
I2C ADDR 0bXXX 000X
Address: 0xA0 [0b1010 0(p3) 0(p2) 0(p1) R/*W]
NOTE: The ESP32 carrier board has headers on the bottom. Thus the carrier board header socket pinout is identical to the ESP32 board as viewed from above.
Current through LEDs is 200mV / R27. 20mA = 10 Ohm
Pullups on I2C Lines may not be necessary
I2C Addr 0x38

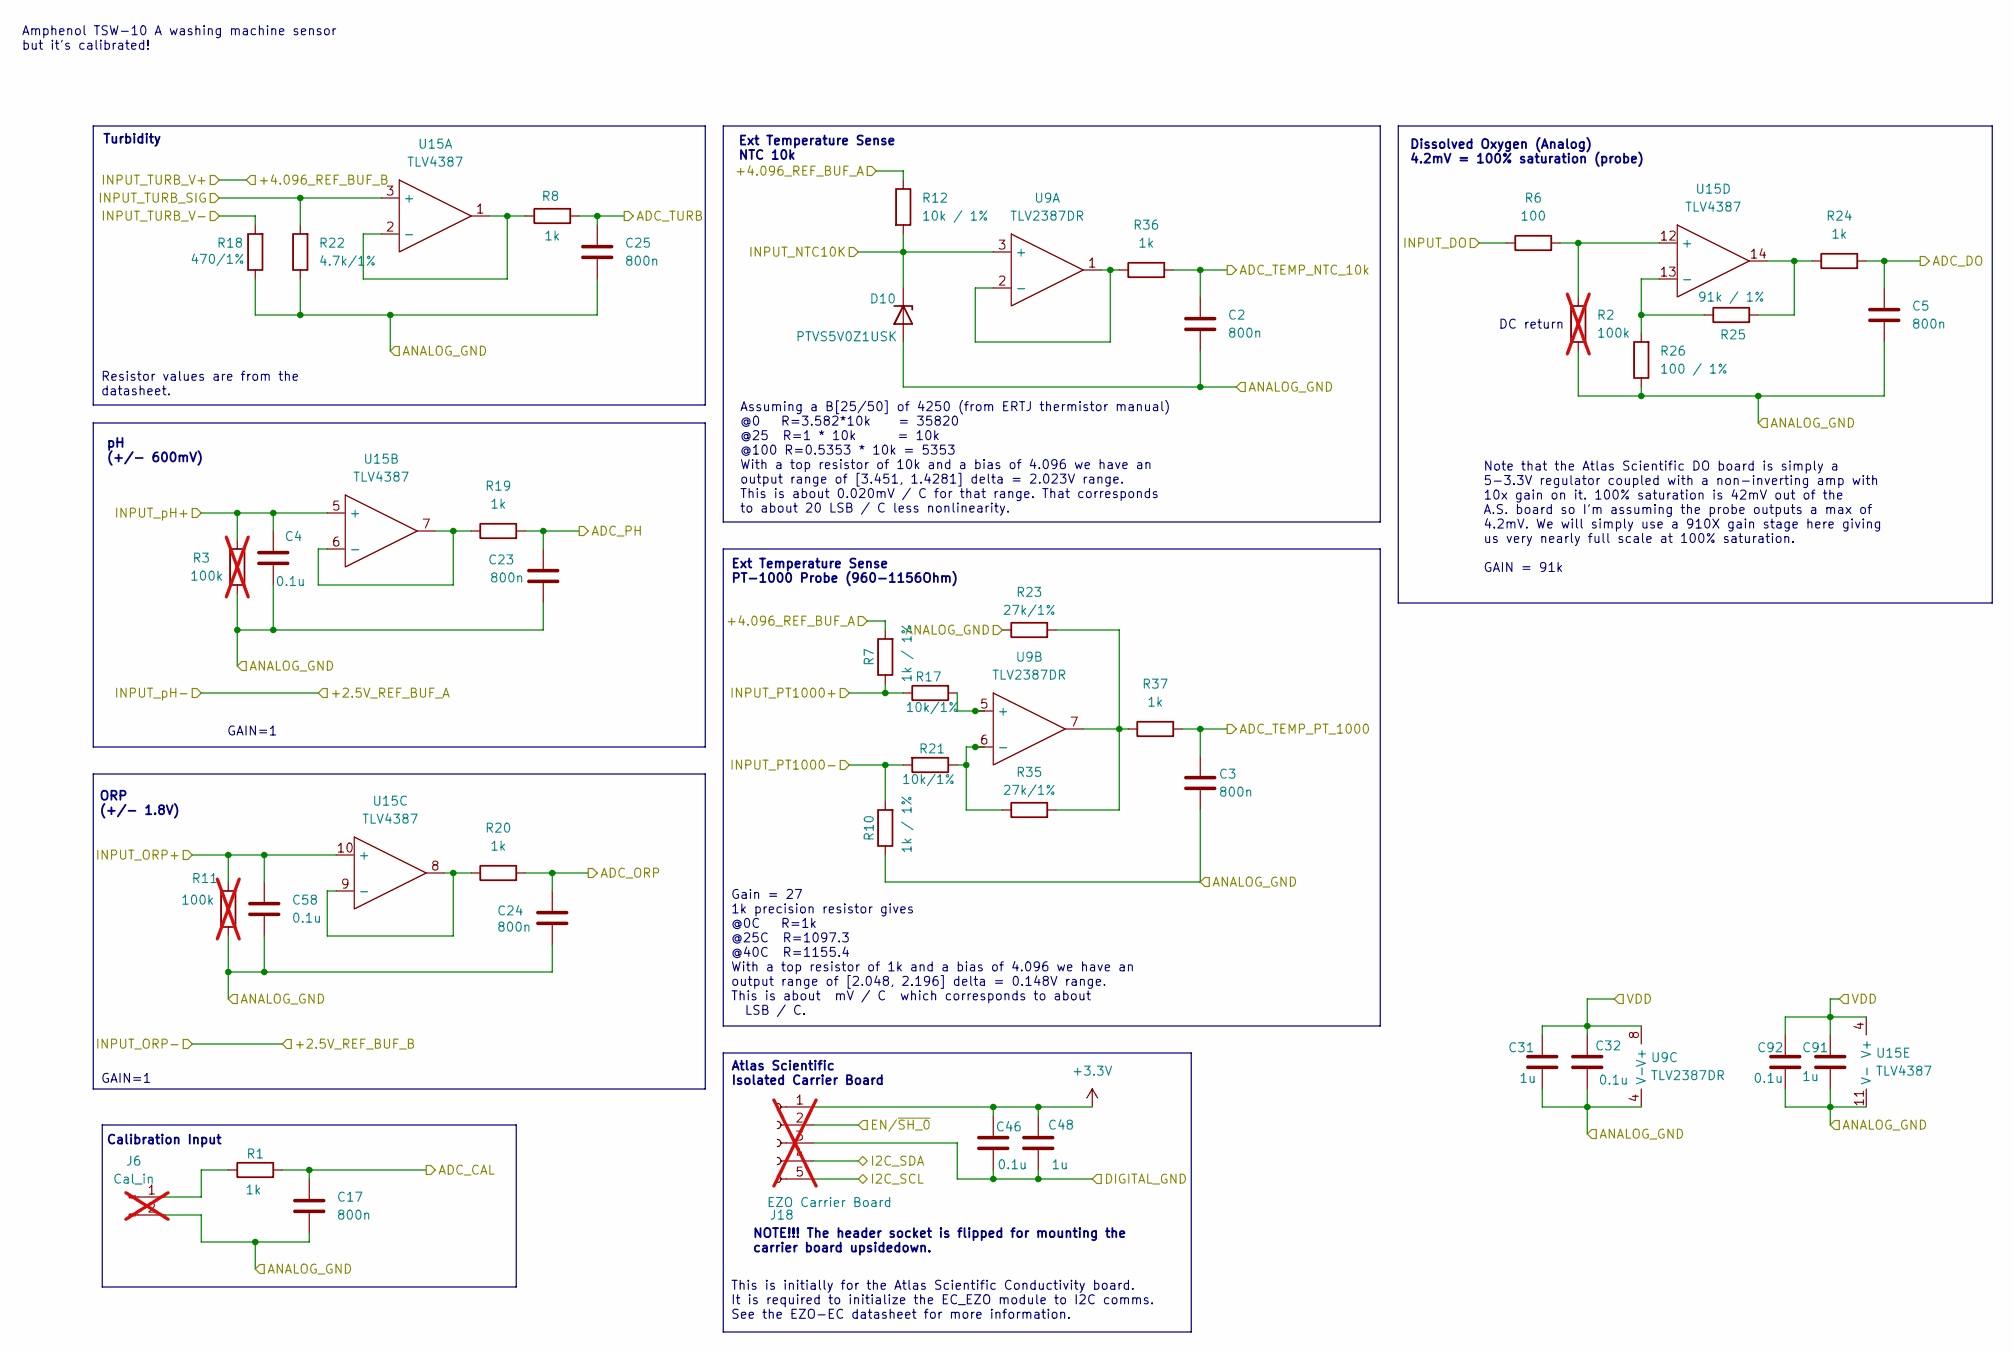
[picture p9: schematic sensor_module_4.kicad_sch]

Parts:
C2, C3, C5, C17, C23, C24, C25: 800n; C_0805_2012Metric_Pad1.18x1.45mm_HandSolder; MPN CC0805KKX7R7BB824
C4, C32, C46, C58, C92: 0.1u; C_0805_2012Metric_Pad1.18x1.45mm_HandSolder; MPN CC0805KRX7R7BB104
C31, C48, C91: 1u; C_0805_2012Metric_Pad1.18x1.45mm_HandSolder; MPN CL21B105KOFNNNG
D10: PTVS5V0Z1USK; Nexperia_DSN1608-2_1.6x0.8mm; MPN PTVS5V0Z1USK
J6: Cal_in; PinHeader_1x02_P2.54mm_Vertical_SMD_Pin1Left; not fitted
J18: EZO Carrier Board; PinSocket_1x05_P2.54mm_Vertical_SMD_Pin1Left; not fitted
R1, R8, R19, R20, R24, R36, R37: 1k; R_0805_2012Metric_Pad1.20x1.40mm_HandSolder; MPN AC0805FR-7W1KL
R2, R3, R11: 100k; R_0805_2012Metric_Pad1.20x1.40mm_HandSolder; MPN AC0805FR-7W100KL; not fitted
R6: 100; R_0805_2012Metric_Pad1.20x1.40mm_HandSolder; MPN AC0805FR-7W100RL
R7, R10: 1k / 1%; R_0805_2012Metric_Pad1.20x1.40mm_HandSolder; MPN AC0805FR-7W1KL
R12: 10k / 1%; R_0805_2012Metric_Pad1.20x1.40mm_HandSolder; MPN AC0805FR-7W10KL
R17, R21: 10k/1%; R_0805_2012Metric_Pad1.20x1.40mm_HandSolder; MPN AC0805FR-7W10KL
R18: 470/1%; R_0805_2012Metric_Pad1.20x1.40mm_HandSolder; MPN RCC0805470RFKEA
R22: 4.7k/1%; R_0805_2012Metric_Pad1.20x1.40mm_HandSolder; MPN AC0805FR-7W4K7L
R23, R35: 27k/1%; R_0805_2012Metric_Pad1.20x1.40mm_HandSolder; MPN RC0805FR-7W27KL
R25: 91k / 1%; R_0805_2012Metric_Pad1.20x1.40mm_HandSolder; MPN AC0805FR-7W91KL
R26: 100 / 1%; R_0805_2012Metric_Pad1.20x1.40mm_HandSolder; MPN AC0805FR-7W100RL
U9: TLV2387DR; SOIC-8_3.9x4.9mm_P1.27mm; MPN TLV2387DR
U15: TLV4387; TSSOP-14_4.4x5mm_P0.65mm; MPN TLV4387PWR

Connections:
+3.3V: C46.1, C48.1, J18.1; also elsewhere on the board
+VSW: C31.1, C32.1, C91.1, C92.1, U9.8 (V+), U15.4 (V+); also elsewhere on the board
/ADC_VREF: R7.2, R12.1; also elsewhere on the board
/EN/~SH_0: J18.2; also elsewhere on the board
/I2C_SCL: J18.5; also elsewhere on the board
/I2C_SDA: J18.4; also elsewhere on the board
/Sensor Module Prototype/ADC_CAL: C17.1, R1.2; also elsewhere on the board
/Sensor Module Prototype/ADC_DO: C5.1, R24.2; also elsewhere on the board
/Sensor Module Prototype/ADC_ORP: C24.1, R20.2; also elsewhere on the board
/Sensor Module Prototype/ADC_PH: C23.1, R19.2; also elsewhere on the board
/Sensor Module Prototype/ADC_TEMP_NTC_10k: C2.1, R36.2; also elsewhere on the board
/Sensor Module Prototype/ADC_TEMP_PT_1000: C3.1, R37.2; also elsewhere on the board
/Sensor Module Prototype/ADC_TURB: C25.1, R8.2; also elsewhere on the board
/Sensor Module Prototype/INPUT_DO: R6.1; also elsewhere on the board
/Sensor Module Prototype/INPUT_NTC10K: D10.1 (K), R12.2, U9.3 (+); also elsewhere on the board
/Sensor Module Prototype/INPUT_ORP+: C58.1, R11.2, U15.10 (+); also elsewhere on the board
/Sensor Module Prototype/INPUT_PT1000+: R7.1, R17.1; also elsewhere on the board
/Sensor Module Prototype/INPUT_PT1000-: R10.2, R21.2; also elsewhere on the board
/Sensor Module Prototype/INPUT_TURB_SIG: R22.2, U15.3 (+); also elsewhere on the board
/Sensor Module Prototype/INPUT_TURB_V-: R18.2; also elsewhere on the board
/Sensor Module Prototype/INPUT_pH+: C4.1, R3.2, U15.5 (+); also elsewhere on the board
GNDA: C2.2, C3.2, C4.2, C5.2, C17.2, C23.2, C24.2, C25.2, C31.2, C32.2, C58.2, C91.2, C92.2, D10.2 (A), J6.2, R2.1, R3.1, R10.1, R11.1, R18.1, R22.1, R23.1, R26.1, U9.4 (V-), U15.11 (V-); also elsewhere on the board
GNDD: C46.2, C48.2, J18.3; also elsewhere on the board
unnamed: J6.1, R1.1
unnamed: R23.2, R35.2, R37.1, U9.7
unnamed: R24.1, R25.2, U15.14
unnamed: R36.1, U9.1, U9.2 (-)
unnamed: R17.2, U9.5 (+)
unnamed: R21.1, R35.1, U9.6 (-)
unnamed: R8.1, U15.1, U15.2 (-)
unnamed: R19.1, U15.6 (-), U15.7
unnamed: R20.1, U15.8, U15.9 (-)
unnamed: R2.2, R6.2, U15.12 (+)
unnamed: R25.1, R26.2, U15.13 (-)

Notes on the sheet:
Atlas Scientific Isolated Carrier Board
Turbidity
DC return
Amphenol TSW-10 A washing machine sensor but it's calibrated!
GAIN=1
Resistor values are from the datasheet.
ORP (+/- 1.8V)
pH (+/- 600mV)
Note that the Atlas Scientific DO board is simply a 5-3.3V regulator coupled with a non-inverting amp with 10x gain on it. 100% saturation is 42mV out of the A.S. board so I'm assuming the probe outputs a max of 4.2mV. We will simply use a 910X gain stage here giving us very nearly full scale at 10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
Ext Temperature Sense PT-1000 Probe (960-1156Ohm)
Dissolved Oxygen (Analog) 4.2mV = 100% saturation (probe)
This is initially for the Atlas Scientific Conductivity board. It is required to initialize the EC_EZO module to I2C comms. See the EZO-EC datasheet for more information.
Assuming a B[25/50] of 4250 (from ERTJ thermistor manual) @0 R=3.582*10k = 35820 @25 R=1 * 10k = 10k @100 R=0.5353 * 10k = 5353 With a top resistor of 10k and a bias of 4.096 we have an output range of [3.451, 1.4281] delta = 2.023V range. This is about 0.020mV / C for that range. That corresponds 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
NOTE!!! The header socket is flipped for mounting the carrier board upsidedown.
Ext Temperature Sense NTC 10k
Gain = 27 1k precision resistor gives @0C R=1k @25C R=1097.3 @40C R=1155.4 With a top resistor of 1k and a bias of 4.096 we have an output range of [2.048, 2.196] delta = 0.148V range. This is about mV / C which corresponds to about LSB / C.
Calibration Input

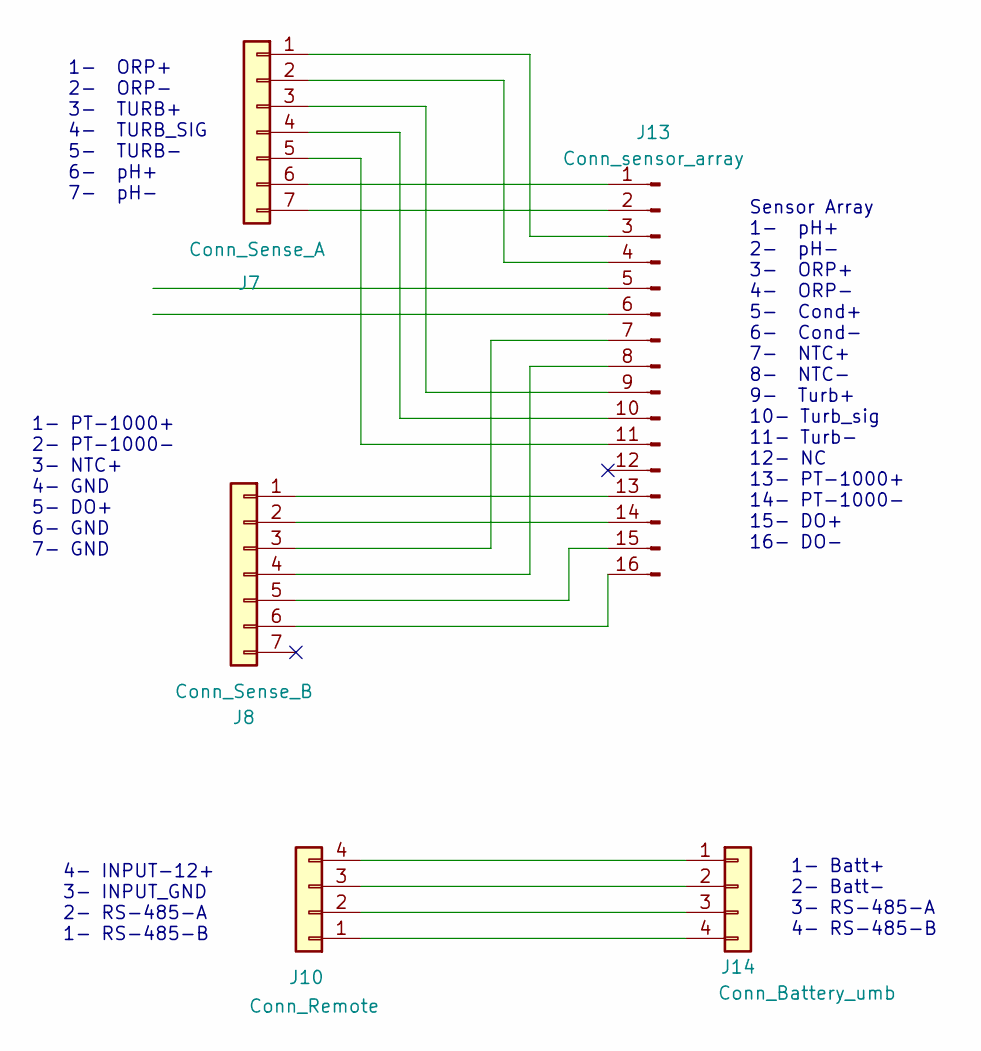
[picture p10: schematic Harness.kicad_sch]

Parts:
J7: Conn_Sense_A; JST_ZH_S7B-ZR-SM4A-TF_1x07-1MP_P1.50mm_Horizontal
J8: Conn_Sense_B; JST_ZH_S7B-ZR-SM4A-TF_1x07-1MP_P1.50mm_Horizontal
J10: Conn_Remote; JST_ZH_S4B-ZR-SM4A-TF_1x04-1MP_P1.50mm_Horizontal
J13: Conn_sensor_array
J14: Conn_Battery_umb

Connections:
unnamed: J10.1, J14.4
unnamed: J10.2, J14.3
unnamed: J10.3, J14.2
unnamed: J10.4, J14.1
unnamed: J7.6, J13.1
unnamed: J7.7, J13.2
unnamed: J7.1, J13.3
unnamed: J7.2, J13.4
unnamed: J8.3, J13.7
unnamed: J8.4, J13.8
unnamed: J7.3, J13.9
unnamed: J7.4, J13.10
unnamed: J7.5, J13.11
unnamed: J8.1, J13.13
unnamed: J8.2, J13.14
unnamed: J8.5, J13.15
unnamed: J8.6, J13.16

Notes on the sheet:
1- Batt+ 2- Batt- 3- RS-485-A 4- RS-485-B
4- INPUT-12+ 3- INPUT_GND 2- RS-485-A 1- RS-485-B
Sensor Array 1- pH+ 2- pH- 3- ORP+ 4- ORP- 5- Cond+ 6- Cond- 7- NTC+ 8- NTC- 9- Turb+ 10- Turb_sig 11- Turb- 12- NC 13- PT-1000+ 14- PT-1000- 15- DO+ 16- DO-
1- ORP+ 2- ORP- 3- TURB+ 4- TURB_SIG 5- TURB- 6- pH+ 7- pH-
1- PT-1000+ 2- PT-1000- 3- NTC+ 4- GND 5- DO+ 6- GND 7- GND
