Digital-Waters/WaterMonitorDeviceESP32/digital_waters.kicad_pcb

## KiCad design digital_waters.kicad_pcb (continued)

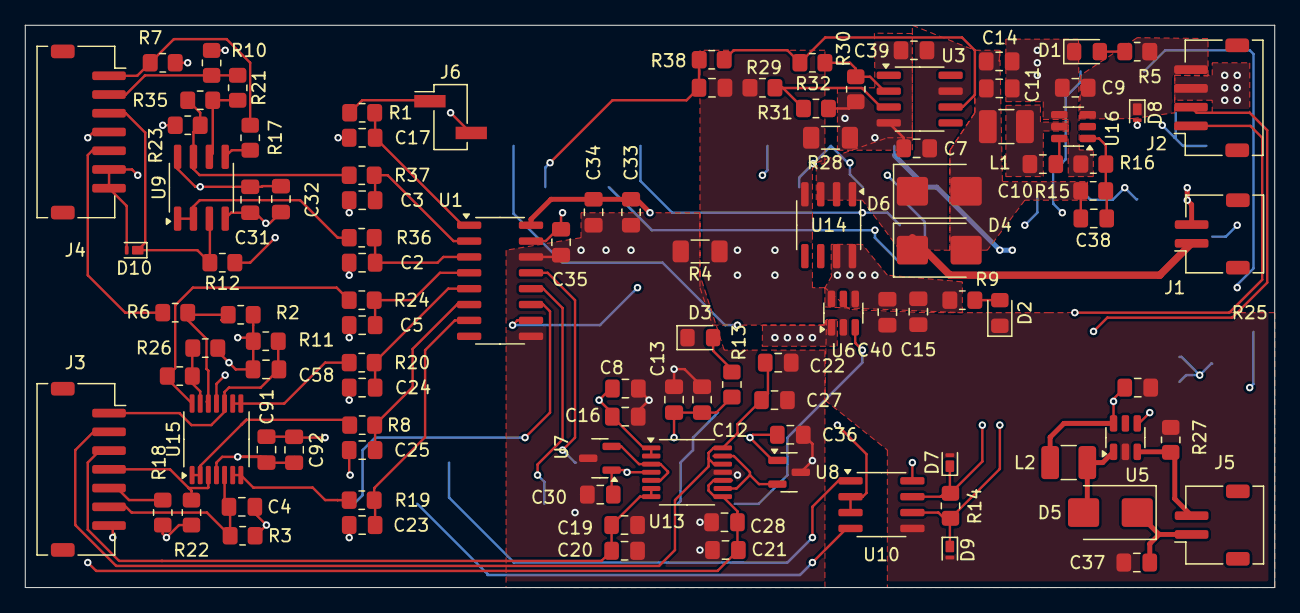
[picture p11: board digital_waters.kicad_pcb from above]

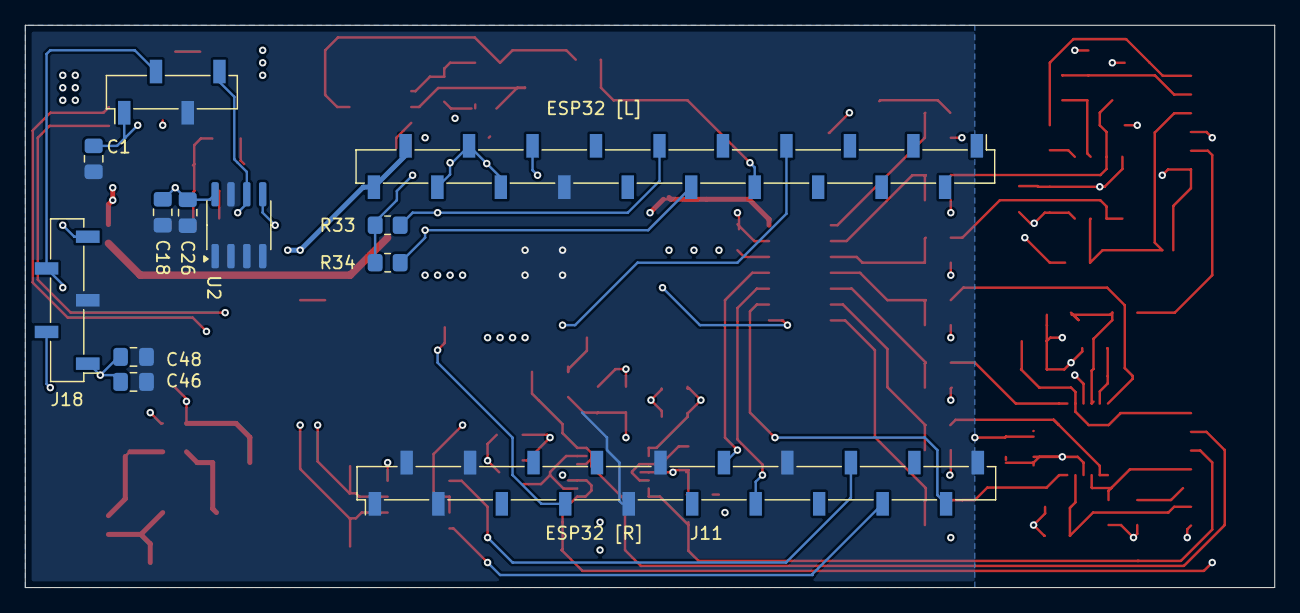
[picture p12: board digital_waters.kicad_pcb from below]

Board: 4 copper layers, 100.0 x 45.0 mm, 118 parts (12 on the bottom side), 66 nets.
