Digital-Waters/WaterMonitorDeviceESP32/(commit log)

2025-07-25 Inception Moving this project from atop8918's repo to the Digital Waters' repo
    [conductivity_4.kicad_sch, digital_sensor_4.kicad_sch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]
2025-09-15 Prototype v0.3.1 WIP Just a maintenance checkin. Many changes - Removed the Base Sensor schematic and put all sensors into SensorPrototype - Added a constant current LED driver for camera illuminatio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
    [digital_waters.kicad_pcb, digital_waters.kicad_sch, microcontroller.kicad_sch, power.kicad_sch, sensor_base.kicad_sch, sensor_module_4.kicad_sch]
2025-09-22 Board V0.0.3 Everything is routed and connected ERC and DRC run without serious error. (There are DRC violations due to a VSSP-83x3mm package but I'm not sure why)
    [digital_waters.kicad_pcb, digital_waters.kicad_sch, microcontroller.kicad_sch, power.kicad_sch, sensor_module_4.kicad_sch]
2025-09-23 BUG FIX -------- There were some issues with the board WRT manufacturing. I changed the VSSOP 8 packages to SOT versions and re-routed
    [digital_waters.kicad_pcb, digital_waters.kicad_sch, power.kicad_sch, sensor_module_4.kicad_sch]
2025-11-18 Maintenance update - Adding the EC isolation board schematic - Added a harness page for wireing module together
    [EC-isolation_board.kicad_pcb, EC-isolation_board.kicad_sch, Harness.kicad_sch, digital_waters.kicad_pcb, digital_waters.kicad_sch, microcontroller.kicad_sch, power.kicad_sch, sensor_module_4.kicad_sch]
